CasperAJ/Programming-Interactive-Experiences/images/PIE_11.jpeg

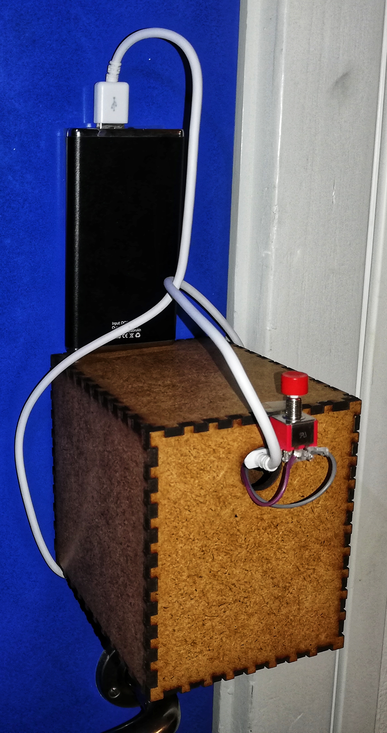
images/PIE_11.jpeg
