CasperAJ/Programming-Interactive-Experiences/images/PIE_12.jpeg

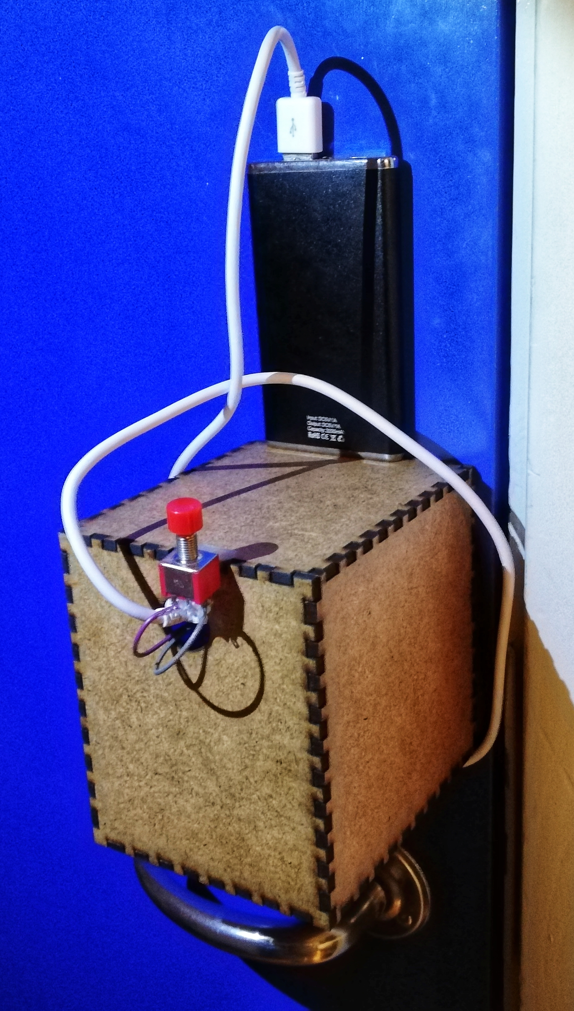
images/PIE_12.jpeg
