CasperAJ/Programming-Interactive-Experiences/images/PIE_Design_Ideas_1.jpg

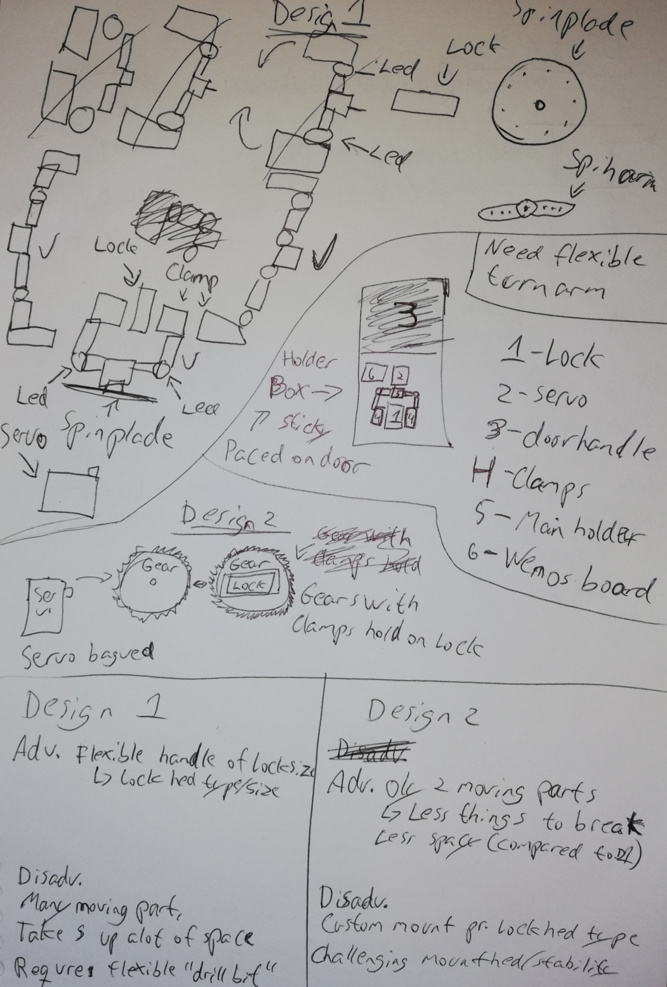
images/PIE_Design_Ideas_1.jpg
