CasperAJ/Programming-Interactive-Experiences/images/PIE_Design_Ideas_2.jpg

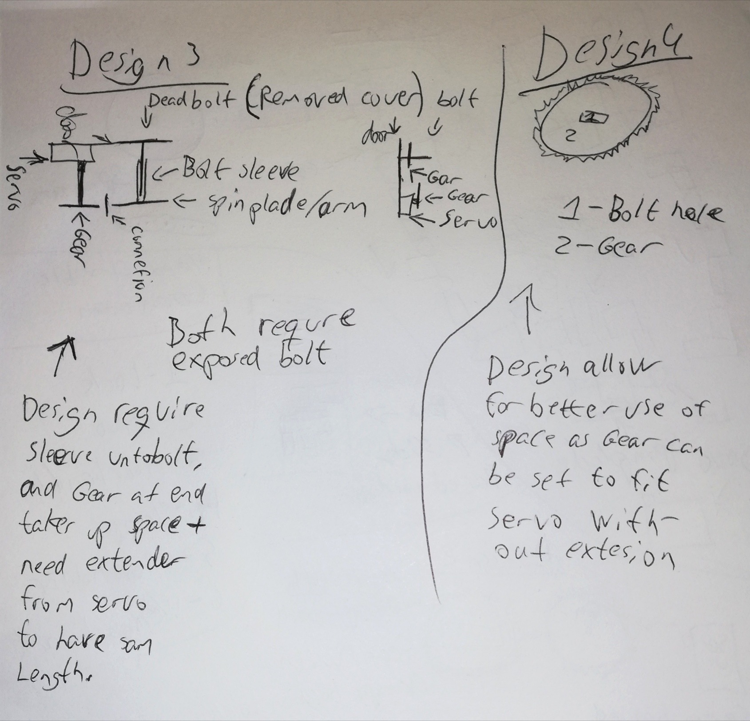
images/PIE_Design_Ideas_2.jpg
