CasperAJ/Programming-Interactive-Experiences/schematics/Lockinpin_Mount.stl

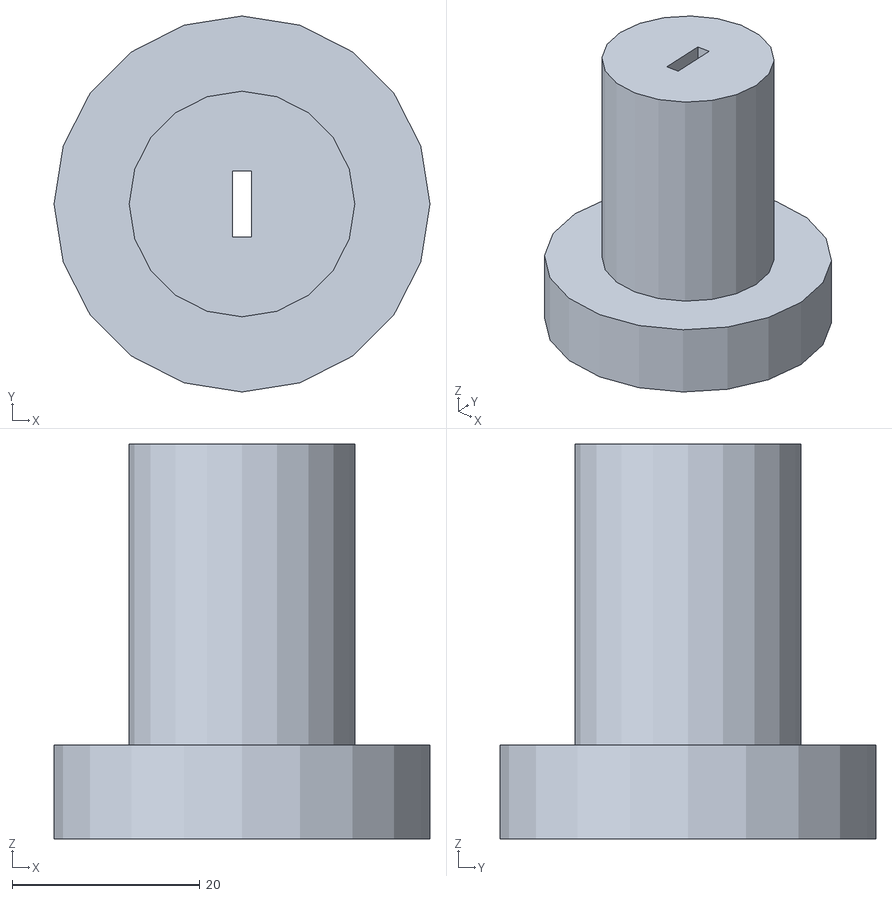
[picture p7: CAD file, 2018-11-25]
schematics/Lockinpin_Mount.stl
40.0 x 40.0 x 42.0
