CasperAJ/Programming-Interactive-Experiences/(commit log)

2018-11-21 Wemos & cable schematic
    Adding the Wemos & Cable schematic for reference
2018-11-21 Adding fancy prototype images
    Adding 9 fancy & improved images
2018-11-22 Added Orgional Case Scematic
2018-11-22 Revert "Added Orgional Case Scematic"
    This reverts commit 51d8ee18758b0828b6c8252c8b703749c8554f25.
2018-11-22 Added Origional Case Schematic
2018-11-25 Added 3D model of lockpin mount
    [Lockinpin_Mount.stl]
2019-01-01 Updated with forgotten comments and fixed a "My code" section encapsulation a wrong closing }
    [sniffer.ino]
